raphdixon/surfclock/README.md

# 🌊 SurfClock

SurfClock solves a simple problem: which beach should you go for a surf at this morning? Rather than showing time, mechanical pointers dynamically track optimal local surf conditions in real-time, translating marine buoy and meteorological telemetry into two simple outputs:

1. Which of your local beaches has the best conditions?
2. How good are the conditions?

> 🤖 **Using an AI Coding Agent (Antigravity, Cursor, Claude Code, Windsurf)?**  
> Don't write code or flash manually! Just point your agent at this repository and tell it:  
> **`"Read AGENT.md and set up my SurfClock."`**  
> Your agent will interview you for your local beaches, configure the firmware, deploy your Google AI Studio / Cloud Run backend, and help calibrate your clock hands!

---

## 🤖 The Modern Way: Point an AI Agent at It

Let's be real: no one is manually modifying C++ and deploying backends line-by-line anymore. The fastest way to get your SurfClock running is to let an AI agent do it for you.

### Option 1: The 30-Second Web Flow (Easiest)
1. Go to [surfclock.web.app](https://surfclock.web.app).
2. Select your coastline or pick your 5 beaches visually on the 3D customizer.
3. Click **"Download Custom Full-Stack Kit (.ZIP)"**.
4. Unzip the package, open your AI agent (Antigravity, Cursor, etc.), and say:
   > *"I downloaded this custom SurfClock kit. Flash it to my ESP32-S3 over USB and help me connect to Wi-Fi."*
   Everything (3D dial STL, C++ stepper angles, and backend coordinates) is already hardcoded for your beaches.

### Option 2: The Agent Questionnaire (Direct from GitHub)
1. Clone this repo: `git clone https://github.com/raphdixon/surfclock.git`.
2. Plug your ESP32-S3 into your computer with a USB-C cable.
3. Tell your AI agent:
   > *"Read `AGENT.md` and set up my SurfClock."*
4. Your agent will conduct a brief questionnaire:
   - Which 5 beaches you want on the dial (from 12 o'clock clockwise).
   - Your local Wi-Fi network SSID and password.
   - Whether you want to deploy your own backend via **Google AI Studio / Cloud Run** or use the public endpoint.
5. The agent automatically calculates GPS coordinates, facing angles, and offshore wind windows, injects them into `firmware/src/stepper_controller.cpp` and `backend/server.js`, builds and uploads the firmware with PlatformIO, and guides hand calibration!
---

## Required Components (Bill of Materials)

| Component | Quantity | Description | Approximate Cost |
| :--- | :---: | :--- | :--- |
| **ESP32-S3 Board** | 1 | Freenove ESP32-S3 WROOM (or standard ESP32 development board with ≥8 free GPIO pins and USB-C). | ~$5 – $8 |
| **28BYJ-48 5V Stepper Motors** | 2 | Geared unipolar 5V stepper motors (2048 steps/revolution, 5mm flatted shaft). Motor 1 drives the break pointer; Motor 2 drives the conditions subdial. | ~$4 – $6 (pair) |
| **ULN2003 Driver Boards** | 2 | Darlington transistor array stepper driver boards (typically bundled with 28BYJ-48 motors). | Bundled with motors |
| **5V USB Power Supply** | 1 | Standard 5V / 1A–2A USB wall brick and USB-C cable (powers the ESP32 and both stepper motors). | Common household item |
| **DuPont Jumper Wires** | 12–16 | Female-to-female jumper wires to connect the ESP32 GPIOs and 5V/GND power rails to the ULN2003 boards. | ~$2 |
| **Wall Clock Enclosure & Hands** | 1 | Pointer hands can be 3D printed, laser cut, or press-fit onto the motor shafts. | Repurposed or ~$10 |

---

## 3D Printing the Enclosure

You can generate the 3D print files for the custom face and enclosure here: [https://surfclock.web.app](https://surfclock.web.app)

SurfClock Exploded Assembly
---

## Wiring & Pinout

Connect the two ULN2003 stepper driver boards to the ESP32-S3:

### Motor 1: Surf Break Pointer (Main Dial)
| ULN2003 Driver 1 Pin | ESP32-S3 GPIO | Wire / Function |
| :--- | :--- | :--- |
| **IN1** | **GPIO 4** | Blue Wire |
| **IN2** | **GPIO 5** | Pink Wire |
| **IN3** | **GPIO 6** | Yellow Wire |
| **IN4** | **GPIO 7** | Orange Wire |
| **+ (VCC)** | **5V / VBUS** | 5V Power Rail |
| **- (GND)** | **GND** | Common Ground |

### Motor 2: Conditions Gauge Needle (Subdial)
| ULN2003 Driver 2 Pin | ESP32-S3 GPIO | Wire / Function |
| :--- | :--- | :--- |
| **IN1** | **GPIO 11** | Blue Wire |
| **IN2** | **GPIO 12** | Pink Wire |
| **IN3** | **GPIO 13** | Yellow Wire |
| **IN4** | **GPIO 14** | Orange Wire |
| **+ (VCC)** | **5V / VBUS** | 5V Power Rail |
| **- (GND)** | **GND** | Common Ground |

*Power Tip:* Both driver boards share the 5V rail and common GND with the ESP32. Stepper coils automatically power down 2 seconds after completing a move to keep the motors cool.

---

## How to Flash the Firmware

SurfClock firmware is built with [PlatformIO](https://platformio.org/).

### 1. Prerequisites
- Install **VS Code** with the **PlatformIO IDE** extension, OR install PlatformIO CLI directly:
  ```bash
  pip install -U platformio
  ```

### 2. Connect Your ESP32-S3
Plug your ESP32-S3 into your computer via a USB-C data cable.

### 3. Build & Flash
Navigate to the `firmware/` directory and upload:
```bash
cd firmware
pio run -t upload
```

### 4. Open the Serial Monitor
```bash
pio device monitor -b 115200
```

### 5. First-Time Setup & Zeroing (No Sensors Needed!)
Once the serial monitor opens, run these interactive commands:

1. **Configure Wi-Fi** (saved directly to flash):
   ```
   wifi "Your-SSID" "Your-Password"
   ```
2. **Point hands to datum position**:
   - Manually turn the main break hand so it points straight up at **12 o'clock** (Position 1).
   - Manually turn the conditions gauge needle to **Rating 1.0** (or minimum mark).
3. **Lock zero positions into flash**:
   ```
   zero
   zero2
   ```
   The clock now locks these positions as Step 0 and remembers them through power cycles and reboots.
4. **Test the movement**:
   ```
   pos 2        # Rotates break pointer to spot 2
   gauge 7.5    # Moves conditions needle to 7.5 / 10
   status       # Displays current step positions and Wi-Fi state
   ```

---

## How to Add Your Own Beaches

SurfClock uses the **Open-Meteo Marine & Weather API**—it is 100% free, requires no API key, and covers ocean coordinates globally.

You can configure SurfClock for your local coastline in two places:
1. **The Backend Spots Config** (`backend/spots.json` or `server/spots.json`): defines the geographic coordinates and oceanographic preferences for each spot, completely separate from the scoring math in `backend/server.js`.
2. **The Clock Dial Mapping** (`firmware/src/stepper_controller.cpp`): maps spot positions to angles on your clock face.

---

### Step 1: Define Your Beaches in the Backend

In `backend/spots.json` (or ask Gemini inside **Google AI Studio** to update it for you!), edit your 5 breaks:

```json
[
  {
    "pos": 1,
    "name": "Trestles",
    "dial_text": "TRESTLES",
    "angle": 0,
    "lat": 33.385,
    "lon": -117.593,
    "facing": 220,
    "swell_min": 180,
    "swell_max": 260,
    "wind_min": 30,
    "wind_max": 90,
    "min_s": 0.8,
    "max_s": 3.5,
    "period": 14
  }
]
```

#### How to Find Beach Parameters:
- **`lat` / `lon`**: Right-click the beach on Google Maps and copy the latitude/longitude coordinates.
- **`facing`**: The compass bearing looking straight out from the sand into the ocean (0° = North, 90° = East, 180° = South, 270° = West).
- **`wind_min` / `wind_max`**: Offshore winds blow from land out to sea (roughly 180° opposite of the beach facing direction $\pm 30^\circ$).
- **`swell_min` / `swell_max`**: Compass angles from which swells can reach the beach without getting blocked by headlands, islands, or points.

---

### Step 2: Map Dial Angles in the Firmware

In `firmware/src/stepper_controller.cpp`, locate `setBeachPosition(int pos)` and update the angles to match your clock face design:

```cpp
bool StepperController::setBeachPosition(int pos) {
    float angle = 0.0f;
    const char* name = "Unknown";
    switch (pos) {
        case 1:
            angle = 0.0f;   name = "Trestles"; break;       // 12 o'clock
        case 2:
            angle = 72.0f;  name = "Huntington"; break;     // ~2:25 on dial
        case 3:
            angle = 144.0f; name = "Malibu"; break;         // ~4:50 on dial
        case 4:
            angle = 216.0f; name = "Rincon"; break;         // ~7:10 on dial
        case 5:
            angle = 288.0f; name = "Steamer Lane"; break;   // ~9:35 on dial
        default:
            Serial.printf("[MOTOR] Invalid beach pos: %d\n", pos);
            return false;
    }
    _currentBeachPos = pos;
    return moveToAngle(angle);
}
```

*Note:* You can support anywhere from 2 to 12 spots on a single clock face!

---

### Step 3: Deploy the Backend

#### Option A: Google AI Studio → 1-Click Deploy to Cloud Run (Recommended — No CLI Needed)
You can customize your beaches with Gemini and host your live `/api/surf` endpoint + web dashboard directly from **Google AI Studio**:

1. Download **[`backend/surfclock-aistudio-backend.zip`](backend/surfclock-aistudio-backend.zip)** from this repo.
2. Open the blank applet template in Code View at **[aistudio.google.com/apps/bundled/blank?showCode=true](https://aistudio.google.com/apps/bundled/blank?showCode=true)** and click **Remix** in the top-right toolbar.
3. In the left **File explorer** panel, click **`+` (`Add items to file explorer`)** → **Upload Zip file** and select **`surfclock-aistudio-backend.zip`**, then press **`Cmd+S`** (or **`Ctrl+S`**).
4. *(Optional)* Ask Gemini right inside AI Studio:
   > *"Update `spots.json` for my 5 local breaks: [Your 5 Beaches] with their GPS coordinates, facing bearings, and offshore wind windows."*
5. Click the **🚀 Deploy to Cloud Run** button in the top-right corner of Google AI Studio:
   - **Region:** Choose a Tier 1 region such as `us-central1` or `us-west1` so your service stays within **Google Cloud Run's $0/month Always Free tier** (the backend caches Open-Meteo telemetry in memory for 10 minutes, using <2% of the free monthly CPU/request quota).
   - **Authentication:** Make sure **"Allow unauthenticated invocations"** is enabled (the ESP32 microcontroller polls `GET /api/surf` directly over Wi-Fi without browser login cookies).
6. Once deployed, copy your Cloud Run URL (`https://<your-service>.run.app`) and set it on your clock via the USB serial monitor:
   ```text
   api https://<your-service>.run.app/api/surf
   ```
   *(Visiting `https://<your-service>.run.app/` in any browser opens your live web telemetry dashboard!)*

#### Option B: Deploy to Google Cloud Run via Terminal (`gcloud` CLI)
If you have the [Google Cloud CLI](https://cloud.google.com/sdk/docs/install) installed, you (or your AI agent) can deploy in one command:
```bash
cd backend
gcloud run deploy surfclock --source . --region us-central1 --allow-unauthenticated
```
Then set the resulting URL on your clock:
```text
api https://<your-service>.run.app/api/surf
```

#### Option C: Local Server (Raspberry Pi / Home Server)
If you prefer running the scoring engine locally on your own LAN:
```bash
cd backend
node server.js
```
This runs the dashboard at `http://<your-local-ip>:3000/` and the clock API at `http://<your-local-ip>:3000/api/surf`.

---

## Serial CLI Command Reference

Connect over USB at **115200 baud** to access real-time diagnostics:

| Command | Arguments | Description |
| :--- | :--- | :--- |
| `status` | – | Prints current step position, target position, Wi-Fi status, and free RAM. |
| `pos` | `<1-12>` | Moves the main break hand to a specific beach position. |
| `angle` | `<0-360>` | Rotates the main hand directly to an exact degree angle. |
| `gauge` | `<1.0-10.0>` | Moves the conditions subdial needle to a rating between 1.0 and 10.0. |
| `step` | `<+/-N>` | Manually nudges Motor 1 forward (+) or backward (-) by $N$ steps. |
| `step2` | `<+/-N>` | Manually nudges Motor 2 forward (+) or backward (-) by $N$ steps. |
| `zero` | – | Locks Motor 1's current position as 12 o'clock (Step 0) into flash (NVS). |
| `zero2` | – | Locks Motor 2's current position as Rating 1.0 (Step 0) into flash (NVS). |
| `cal_beach` | `<1-12>` | Calibrates the current main pointer position as a specific beach position. |
| `wifi` | `<SSID> <PASS>` | Sets and saves Wi-Fi network credentials directly to flash. |
| `api` | `<URL>` | Sets and saves custom scoring API endpoint to flash. |
| `poll` | – | Forces an immediate HTTP GET request to the scoring server. |
| `free` | – | Immediately de-energizes all stepper motor coils. |
| `demo` | – | Toggles a continuous smooth dial sweep demonstration. |

---

## How Surf Quality is Scored

The scoring engine uses a **Surfline-calibrated LOTUS wave model** to translate offshore buoy and wind telemetry into a **0 to 100** score (mapped to the **1.0 to 10.0** gauge and Surfline's 7-tier `VERY_POOR` to `EPIC` scale):

1. **Spectral Period Conversion ($T_m \to T_p$)**: Converts Open-Meteo's mean spectral period ($T_m$) into peak groundswell period ($T_p = 1.22 \times T_m$) and combines primary + secondary swell energy.
2. **Nearshore Shoaling & Refraction ($H_b$)**: Projects offshore swell height into breaking wave face height using directional cosine refraction against each beach's facing angle and Komar-Gaughan period shoaling $(T_p / 10.5)^{0.35}$.
3. **Wave-Size Gating**: Small surf (`<0.6m` / `1–2 ft`) is capped near `POOR` / `POOR_TO_FAIR` even when glassy, matching Surfline's rating scale.
4. **Wind Grooming & Chop Penalty**: Light glassy air (`<7 km/h`) and moderate offshore winds (`7–18 km/h`) boost quality; cross-shore and onshore winds apply progressive chop penalties alongside a local wind-wave chop ratio check.

---
## 🎯 Hand Alignment & Calibration Guide

After assembling your 3D-printed clock face and press-fitting the pointer hands onto the motor shafts, you need to align step 0 so the hands point dead-centre at the dial tick marks.

Because the ESP32 firmware features persistent non-volatile storage (NVS), **you only need to calibrate once**.

### Method 1: AI Agent Vision Loop (Antigravity / WebCam) 🤖👁️

If you are using Google Antigravity or a multimodal AI coding assistant with terminal and vision access, you can automate perfect alignment using a camera:

1. **Point a camera at the clock**: Mount a USB webcam facing the clock dial, or take photos with your phone camera.
2. **Open the serial monitor or grant agent terminal access**: Ensure the agent can send commands to the ESP32 USB serial port at `115200` baud.
3. **Prompt the AI Agent**:
   > *"Look at the camera feed of my SurfClock dial. Inspect the alignment of the main break pointer and conditions subdial needle. Send `step <N>` or `step2 <N>` commands to nudge the motors in small increments until the main pointer points dead-centre at 12 o'clock and the subdial needle points at Rating 1.0. Once aligned, send `zero` and `zero2` to save to flash."*
4. The agent can measure the angular discrepancy from the image, issue relative micro-steps (`step 15`, `step -4`), verify the adjusted position from the next frame, and lock the zero datum into flash memory automatically.

---

### Method 2: Manual Interactive CLI Nudge

You can also calibrate manually in seconds using the interactive serial console:

1. Open the serial monitor:
   ```bash
   pio device monitor -b 115200
   ```
2. Gently move or step the main pointer near 12 o'clock (Position 1).
3. Fine-tune alignment using relative step nudges:
   ```text
   step 20      # Nudge Motor 1 clockwise 20 steps
   step -5      # Nudge Motor 1 counter-clockwise 5 steps
   step2 15     # Nudge Motor 2 (conditions needle) clockwise 15 steps
   step2 -3     # Nudge Motor 2 counter-clockwise 3 steps
   ```
4. Once the needles are centered over 12 o'clock and Rating 1.0:
   ```text
   zero         # Locks Motor 1 step 0 (12 o'clock datum)
   zero2        # Locks Motor 2 step 0 (Rating 1.0 datum)
   ```
5. *(Optional)* If your main hand is already pointing at another beach (e.g. Dee Why at Pos 2), you can immediately calibrate it without rotating back to 12:
   ```text
   cal_beach 2  # Locks current position as Beach Position 2
   ```

---

## 📄 License

MIT License. Open-source and free for all surfers, makers, and tinkerers.
