raphdixon/surfclock/3d_models/main_break_arm.stl

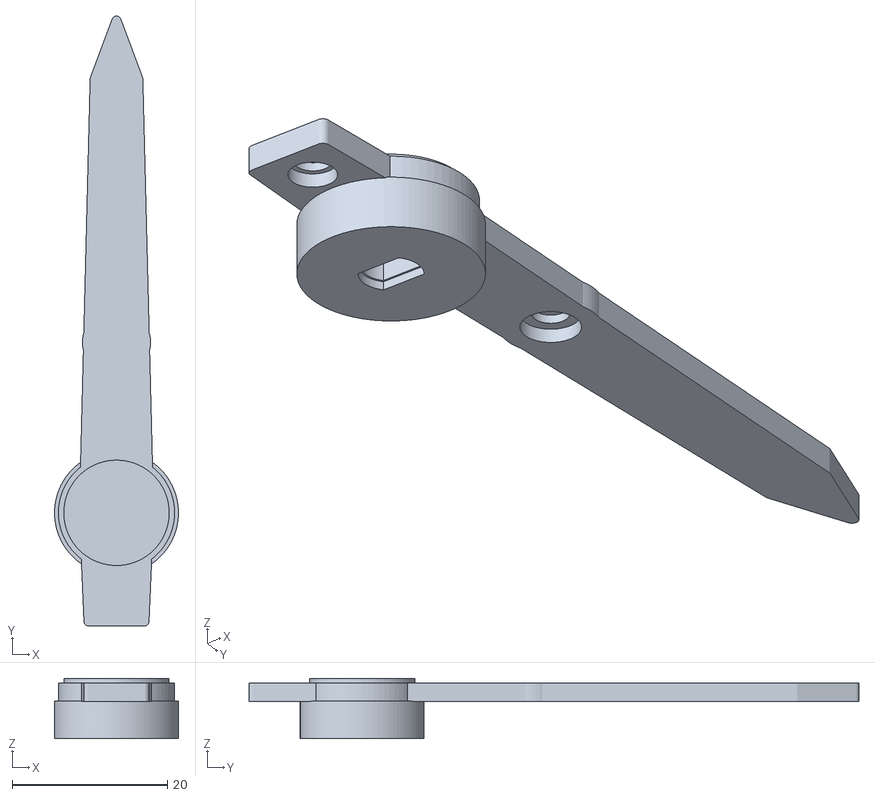
[picture p1: CAD file, 2026-10-21]
3d_models/main_break_arm.stl
16.0 x 78.7 x 7.80
