raphdixon/surfclock/3d_models/desk_stand.stl

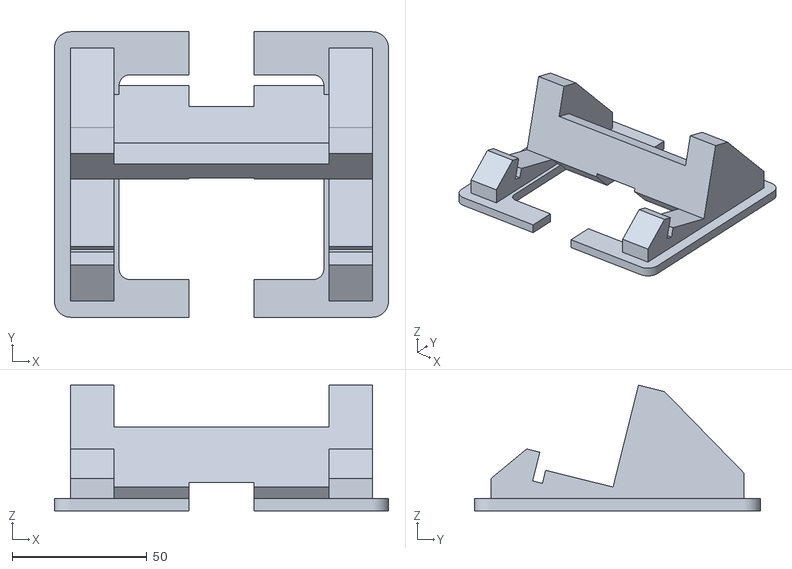
[picture p2: CAD file, 2026-10-21]
3d_models/desk_stand.stl
124.0 x 106.0 x 46.7
