raphdixon/surfclock/3d_models/surfclock_face_minimal.stl

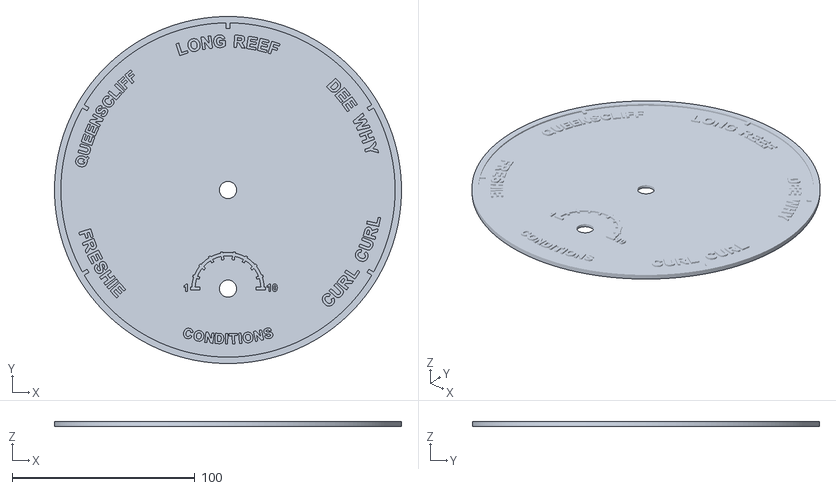
[picture p3: CAD file, 2026-10-21]
3d_models/surfclock_face_minimal.stl
190.0 x 190.0 x 2.60
