raphdixon/surfclock/3d_models/surfclock_face.stl

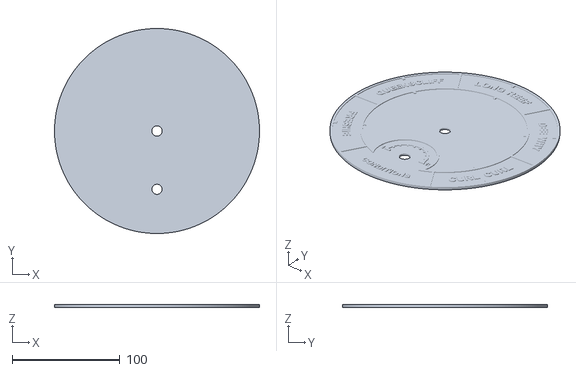
[picture p4: CAD file, 2026-10-21]
3d_models/surfclock_face.stl
190.0 x 190.0 x 2.60
