raphdixon/surfclock/3d_models/back_compartment_chassis.stl

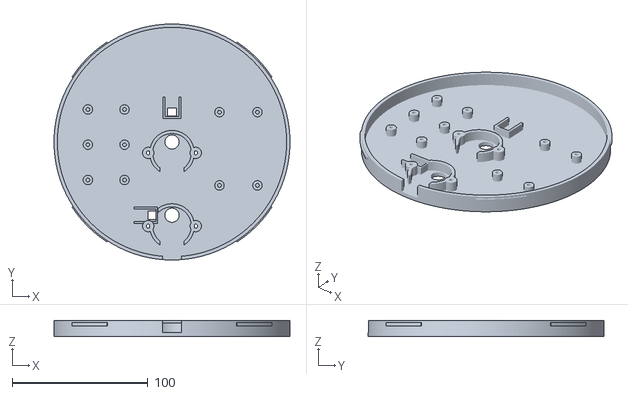
[picture p5: CAD file, 2026-10-21]
3d_models/back_compartment_chassis.stl
174.0 x 174.0 x 12.0
