raphdixon/surfclock/3d_models/conditions_arm.stl

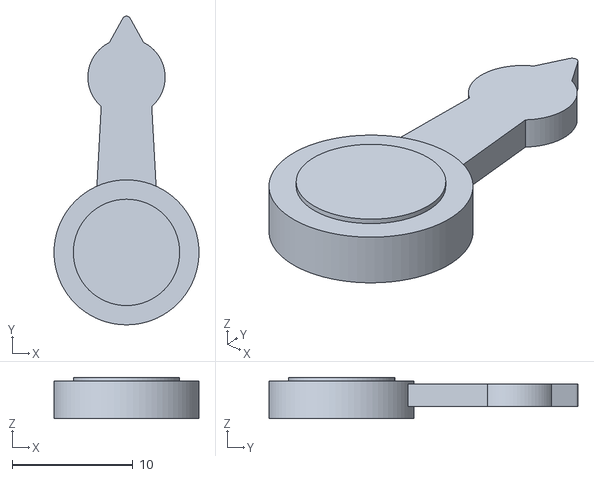
[picture p6: CAD file, 2026-10-21]
3d_models/conditions_arm.stl
12.0 x 25.5 x 3.40
