raphdixon/surfclock/3d_models/back_compartment_cover.stl

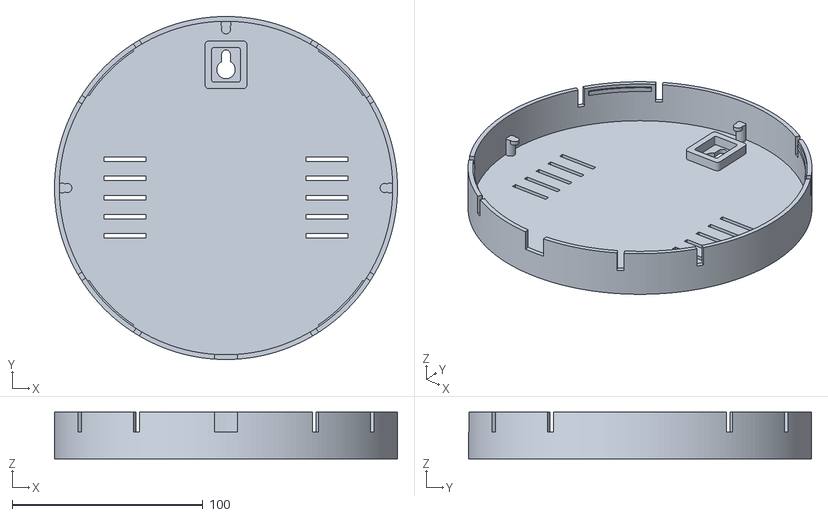
[picture p7: CAD file, 2026-10-21]
3d_models/back_compartment_cover.stl
179.6 x 179.6 x 24.5
