raphdixon/surfclock/(list of files, cad)

Other CAD files:
3d_models/surfclock_complete.blend
