raphdixon/surfclock/(commit log)

2026-09-29 docs: add hand calibration guide with AI vision loop in Antigravity
2026-09-29 docs: add AGENT.md guide, modern AI setup workflows, and exploded CAD assembly GIF
2026-09-30 fix(cli): preserve case for wifi credentials and add scan command
    [cli_handler.cpp]
2026-10-15 Calibrate scoring engine to Surfline LOTUS nearshore wave & wind model
2026-10-16 Package Surfline-calibrated AI Studio backend zip and separate spots.json config
